ramseyrt/PiKVM-v2/IMG_9598.jpg

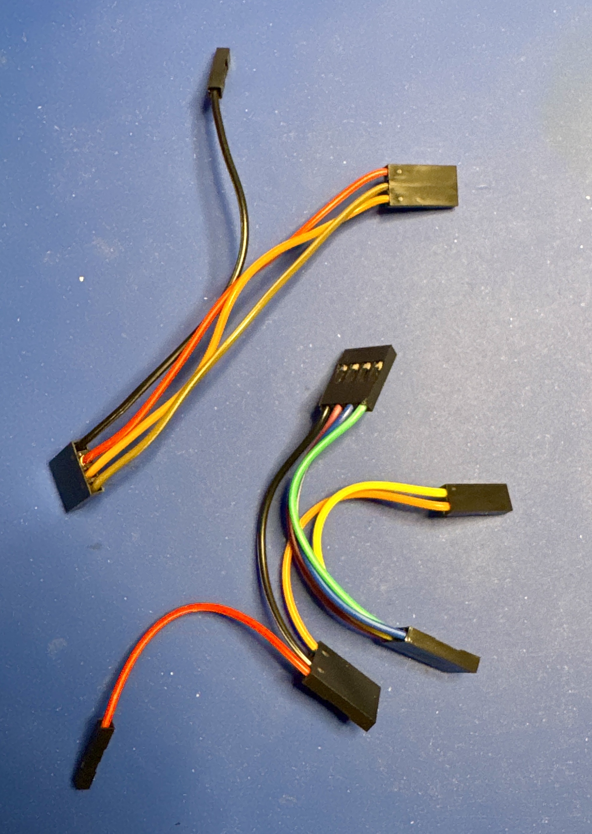
IMG_9598.jpg
