ramseyrt/PiKVM-v2/IMG_9588.jpg

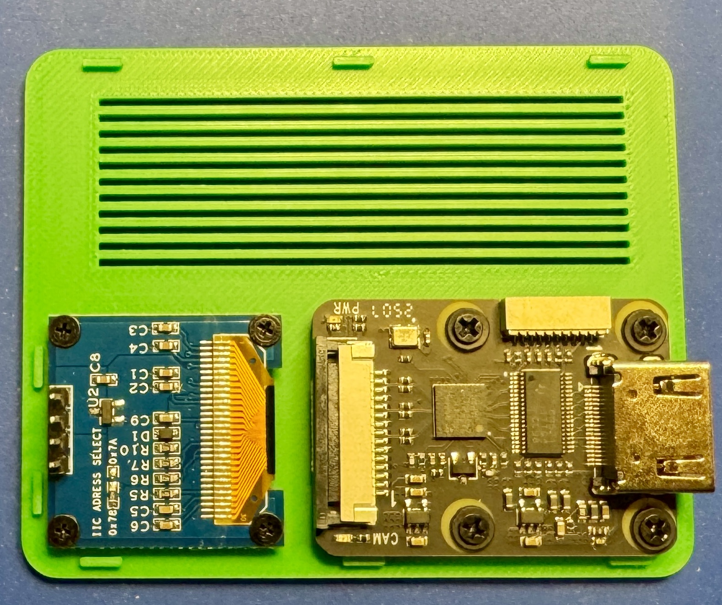
IMG_9588.jpg
