ramseyrt/PiKVM-v2/README.md

Hello,

I’ve been growing my PiKVM v2 build over the last several months and have a working Raspberry Pi Zero 2 W with an OLED status display, X630 HDMI FHD video capture board, and W5500 10/100 Ethernet board working. I’ve also created a custom 3D printable case for it. I’ve attached my build guide and pictures. Please let me know what you think. I’d love to get some feedback.

Thanks in advance!

Rob
