ramseyrt/PiKVM-v2/IMG_9545.jpg

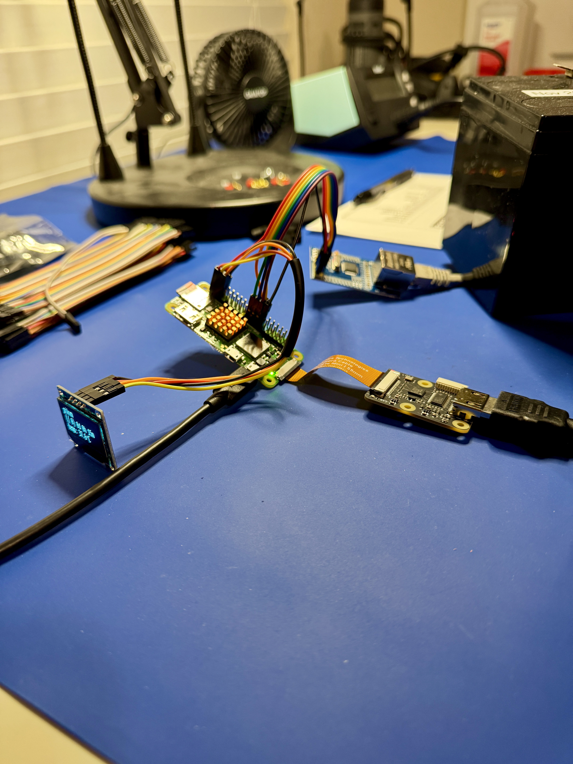
IMG_9545.jpg
