ramseyrt/PiKVM-v2/IMG_9546.jpg

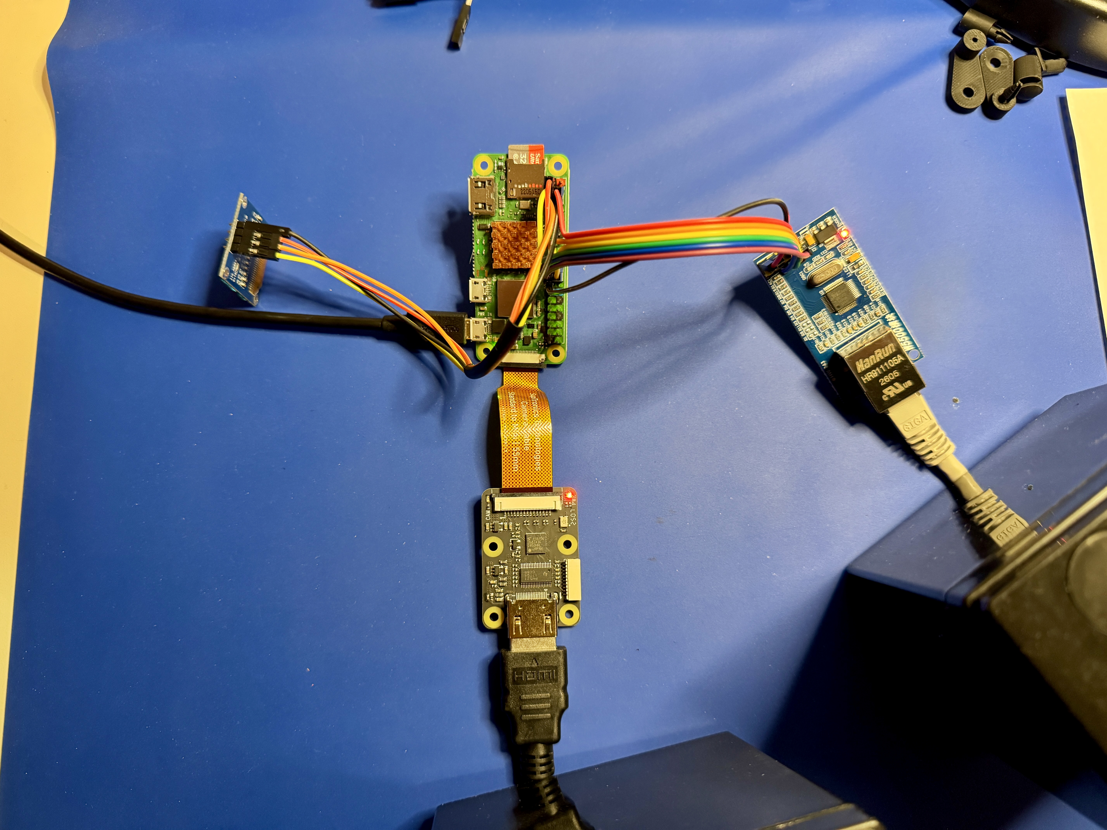
IMG_9546.jpg
