ramseyrt/PiKVM-v2/IMG_9548.JPG

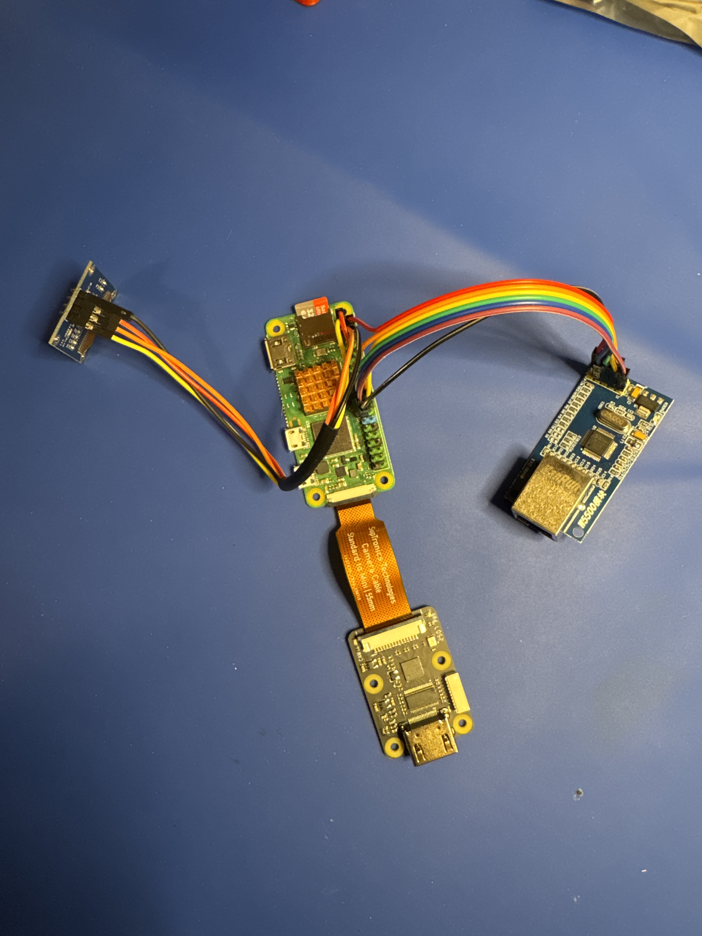
IMG_9548.JPG
