ramseyrt/PiKVM-v2/IMG_9580.jpg

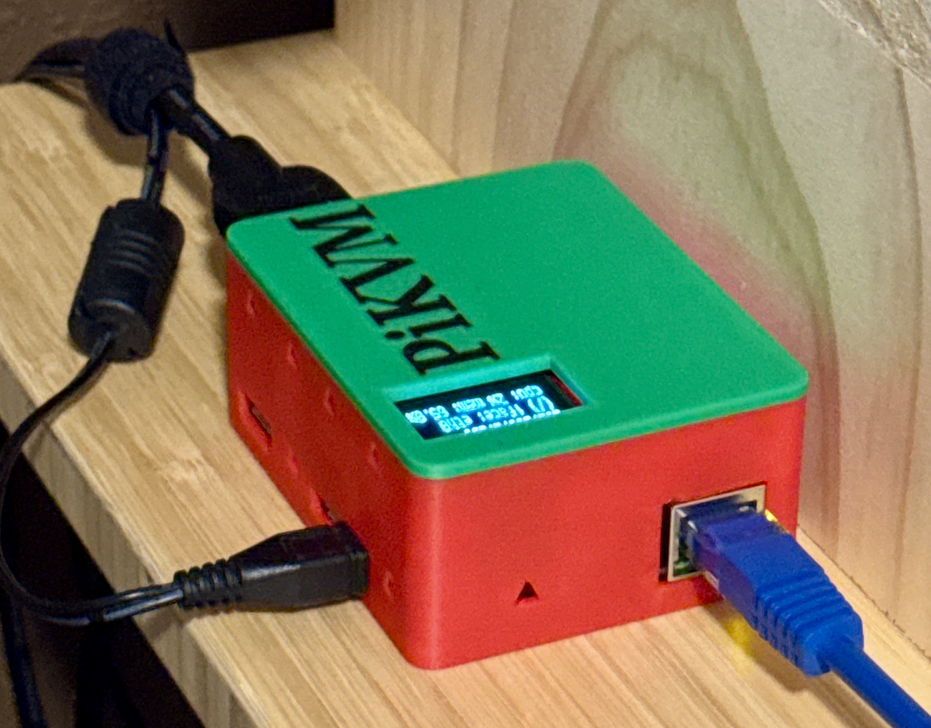
IMG_9580.jpg
