ramseyrt/PiKVM-v2/IMG_9581.jpg

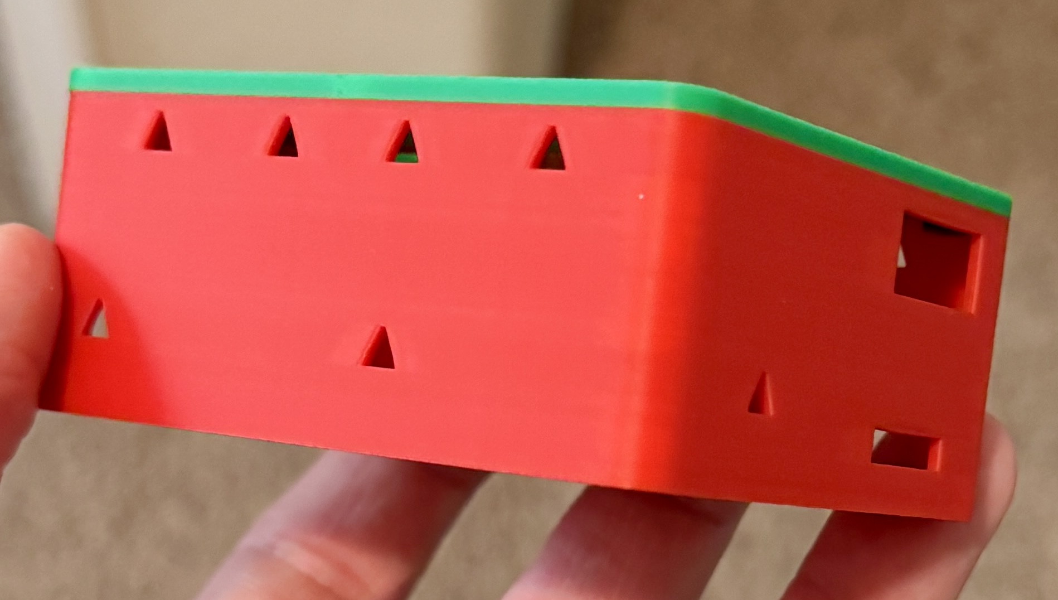
IMG_9581.jpg
