ramseyrt/PiKVM-v2/IMG_9582.jpg

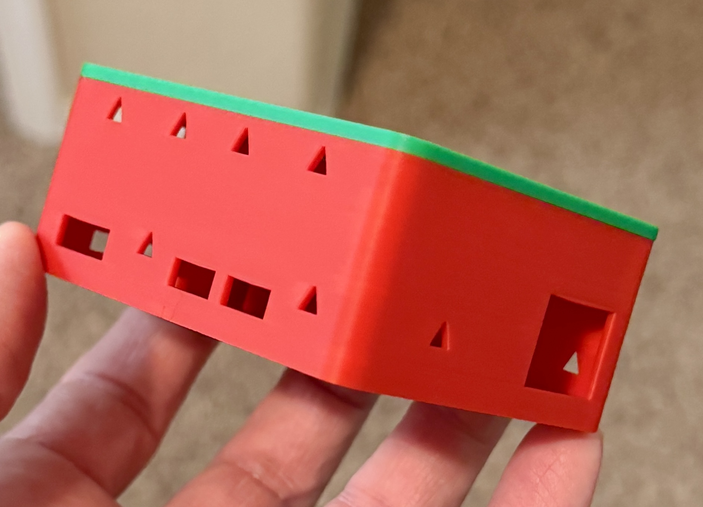
IMG_9582.jpg
