ramseyrt/PiKVM-v2/IMG_9583.jpg

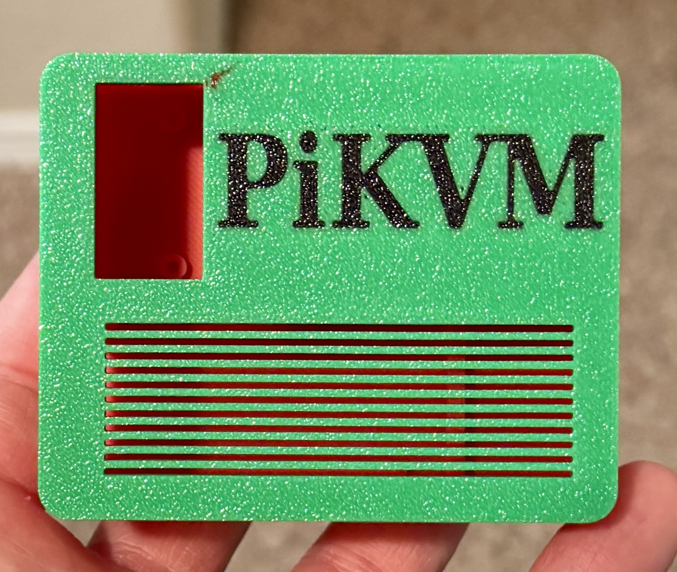
IMG_9583.jpg
