ramseyrt/PiKVM-v2/IMG_9584.jpg

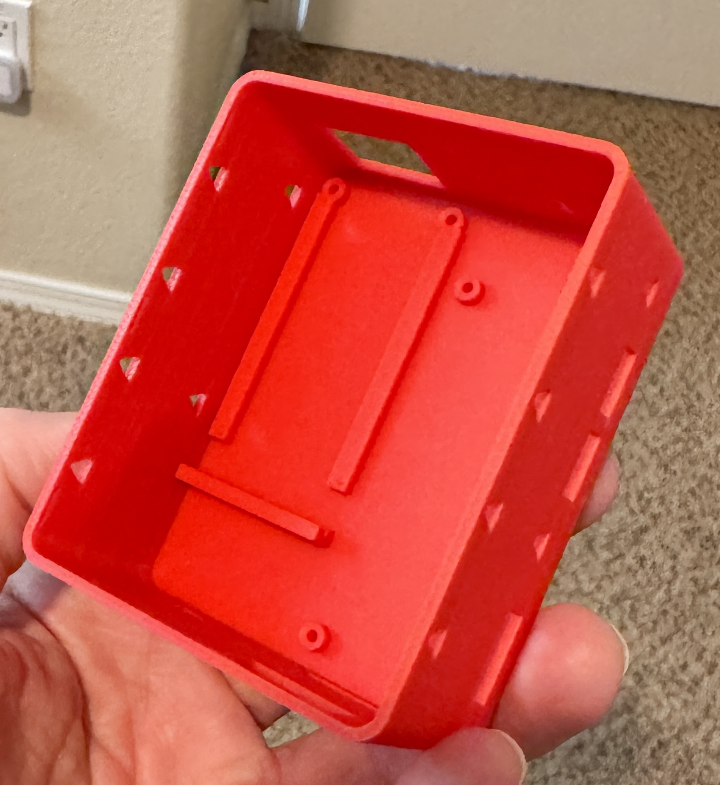
IMG_9584.jpg
