ramseyrt/PiKVM-v2/IMG_9585.jpg

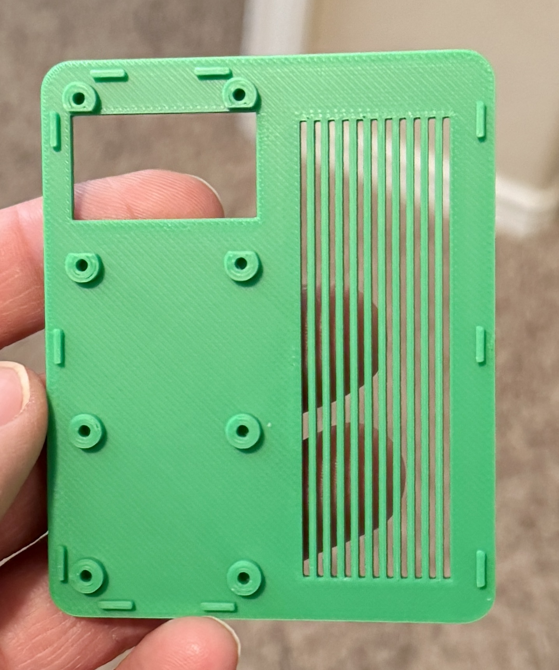
IMG_9585.jpg
