ramseyrt/PiKVM-v2/IMG_9589.jpg

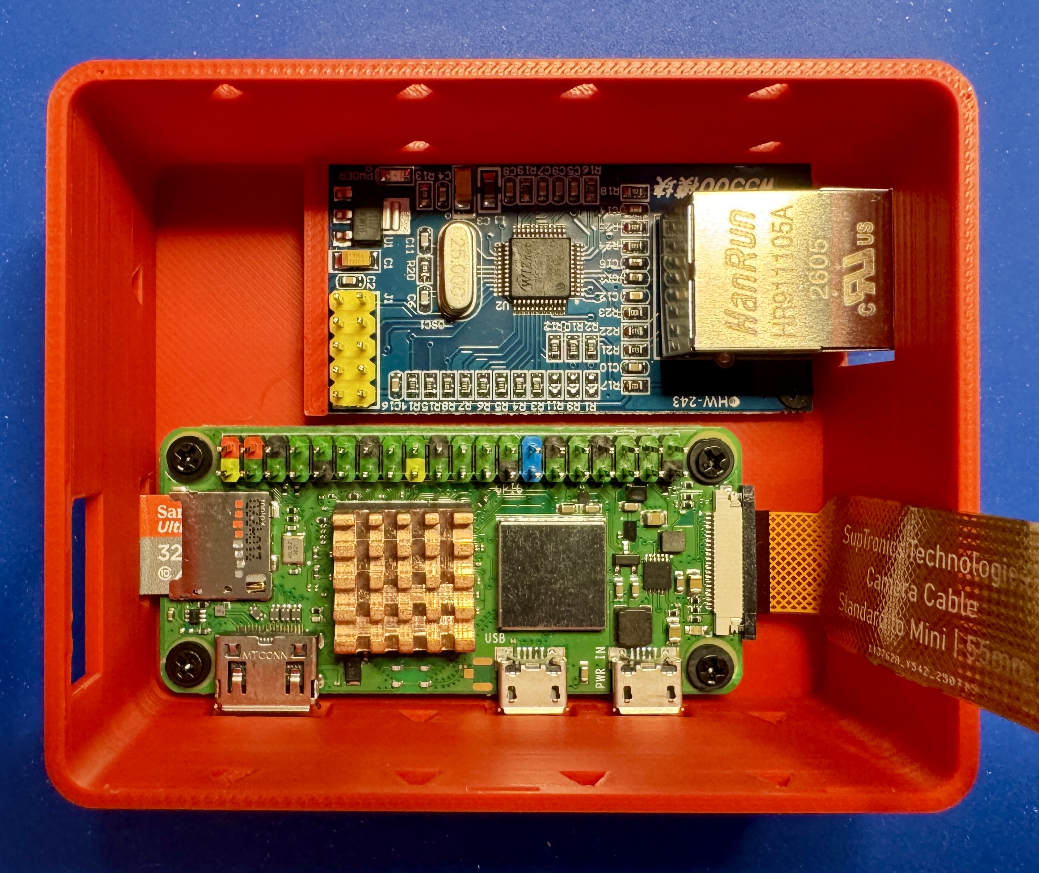
IMG_9589.jpg
