ramseyrt/PiKVM-v2/IMG_9590.jpg

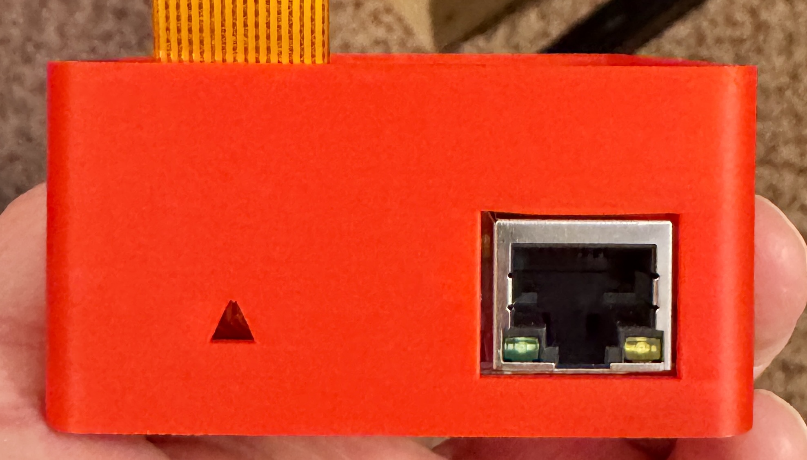
IMG_9590.jpg
