ramseyrt/PiKVM-v2/IMG_9591.jpg

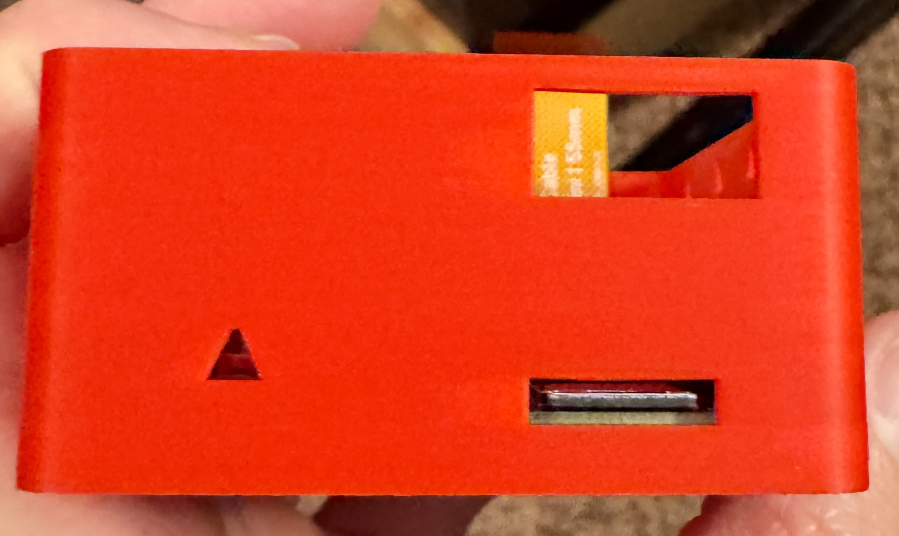
IMG_9591.jpg
