ramseyrt/PiKVM-v2/IMG_9592.jpg

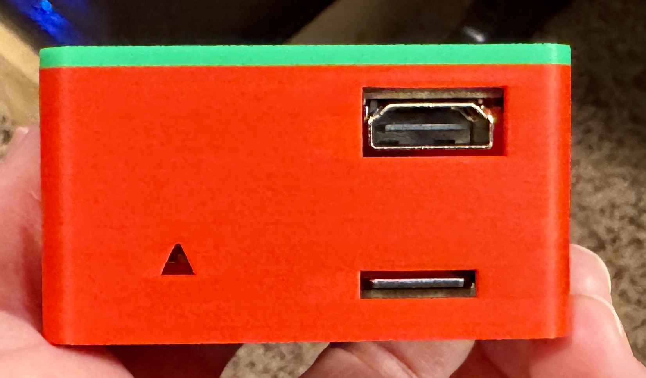
IMG_9592.jpg
