ramseyrt/PiKVM-v2/IMG_9593.jpg

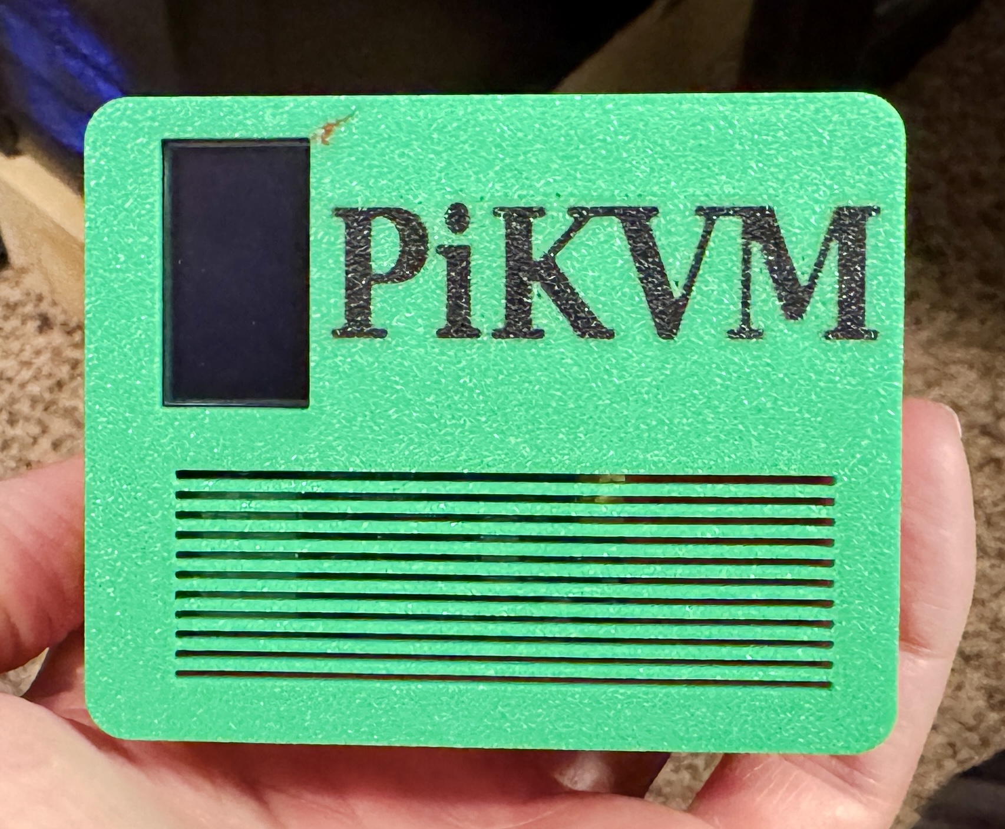
IMG_9593.jpg
