ramseyrt/PiKVM-v2/IMG_9594.jpg

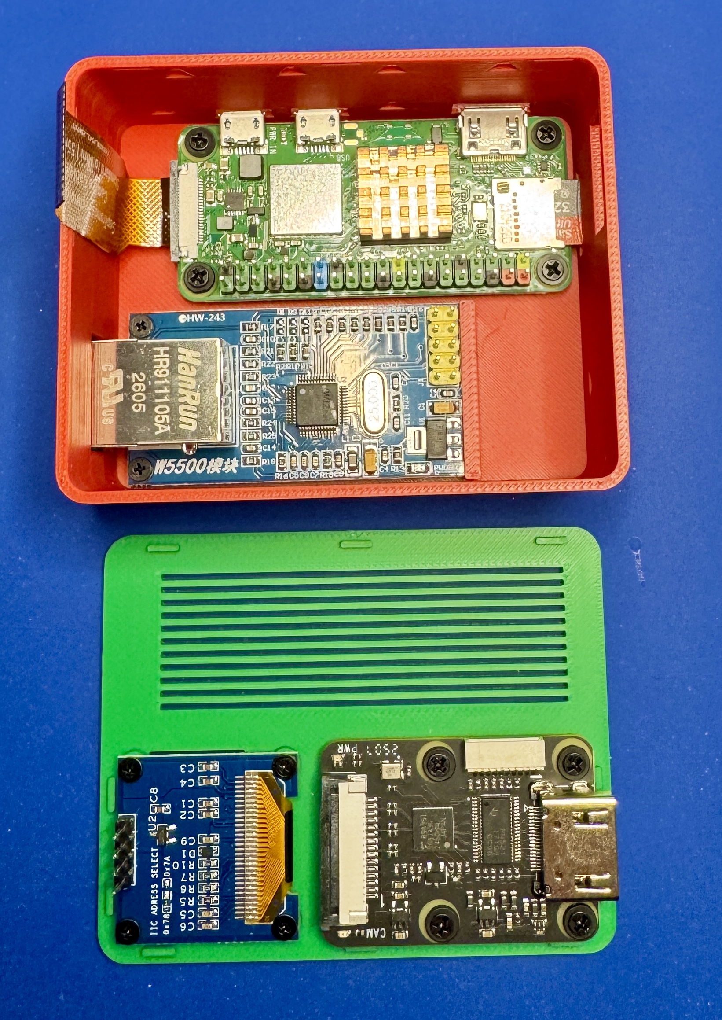
IMG_9594.jpg
