ramseyrt/PiKVM-v2/PiKVM_Case_w_Ethernet.3mf

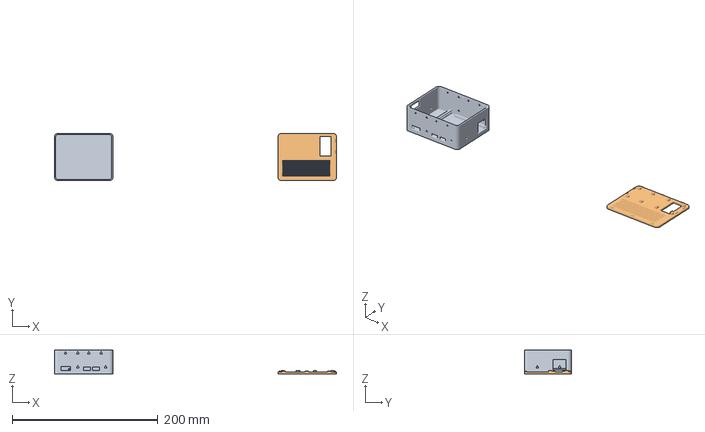
[picture p18: CAD file, 2026-11-05]
PiKVM_Case_w_Ethernet.3mf
387.5 x 64.7 x 32.7 mm
pikvm_body.stl
PiKVM lid
